wu-json/polyfuge/README.txt

Polyfuge
Documentation, Design Files, and Software for the Polyfuge DIY Microcentrifuge 

License

All Polyfuge files including the Polyfuge Educational Packet, User's Guide, BOM, design files, and software, are licensed under [GNU GPLv3](http://www.gnu.org/copyleft/gpl.html).
