wu-json/polyfuge/Polyfuge Educational Packet V1.0.pdf

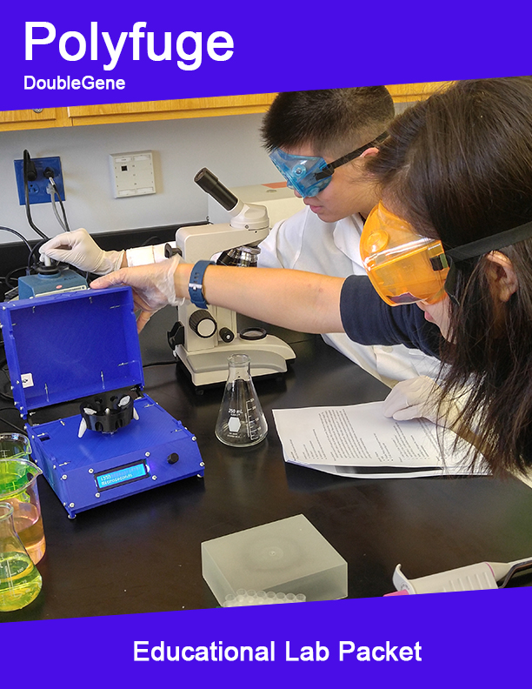
[picture p1: page 1]

## *Warning*: Centrifuges are versatile tools, but can be dangerous when handled incorrectly. Please closely read through the “Important Safety Information” section in the Polyfuge User’s Guide

before continuing.

# Disclaimer

We are not responsible for damages, injuries,

## deaths, or other ill effects arising from proper or improper use of or assembly of the Polyfuge components. To the fullest extent permissible by the applicable law, we hereby disclaim any and all responsibility, risk, liability, and damages arising out of death or personal injury resulting

from assembly of or operation of this kit.

## Polyfuge Educational Lab Packet Version 1.0

4/18/18

Biotechnology is about using living systems to make improvements to the world. From engineering fluorescent plant tissues to creating pharmaceutical drugs for treating diseases, biotechnology is an exciting interdisciplinary study that uses cells and proteins to accomplish various important tasks.

In this packet, we will be using centrifugation to extract various molecular substances using household reagents. By doing so, we will learn about the various chemical and biological principles behind common lab protocols!

In biotechnology, isolation protocols are extremely useful for chemically analyzing particular substances or even obtaining genomic data. In reverse transcription quantitative polymerase chain reaction (RT-qPCR) for example, RNA is extracted, converted to cDNA, and then analyzed with a program to measure relative gene expression.

To start off, make sure you read through the Polyfuge User’s Guide for the safety information and operation instructions. Afterwards, grab a few friends and get started!

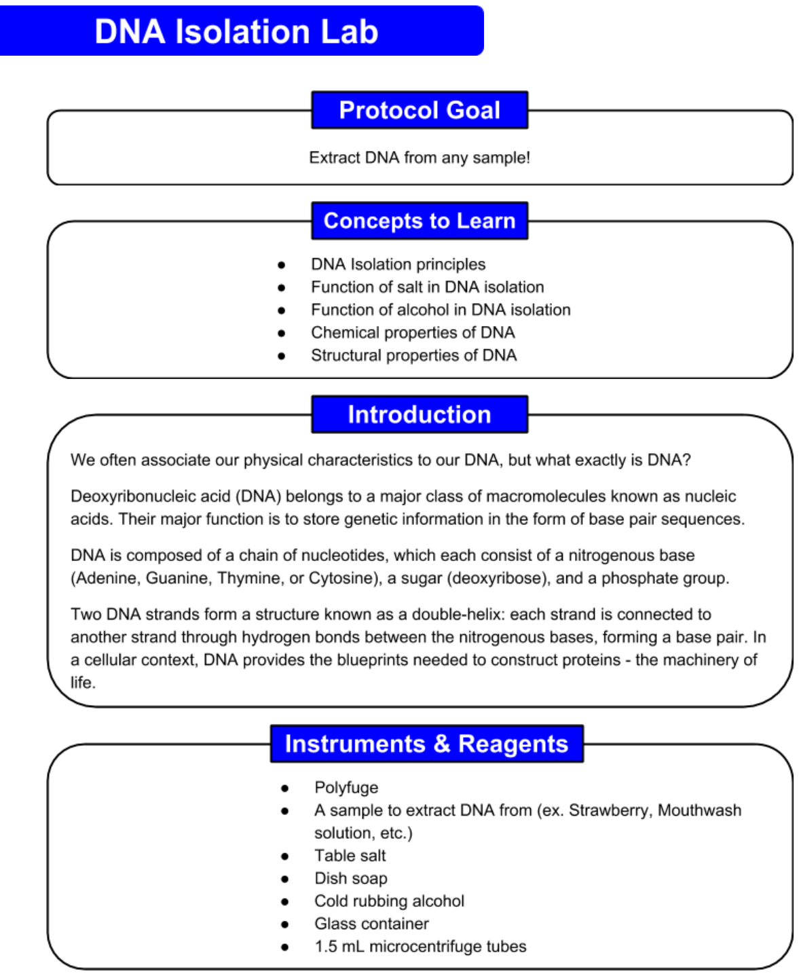
[picture p2: page 4]
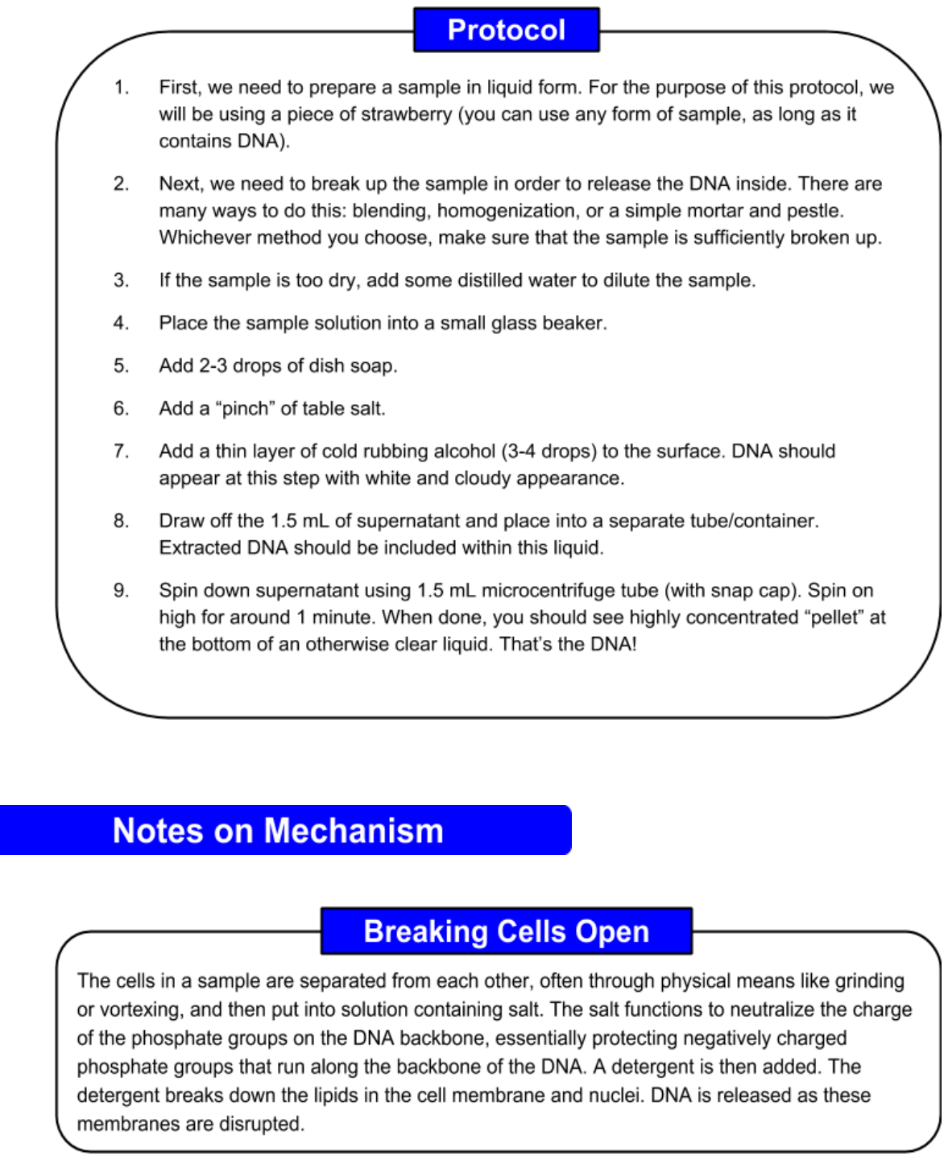
[picture p3: page 5]
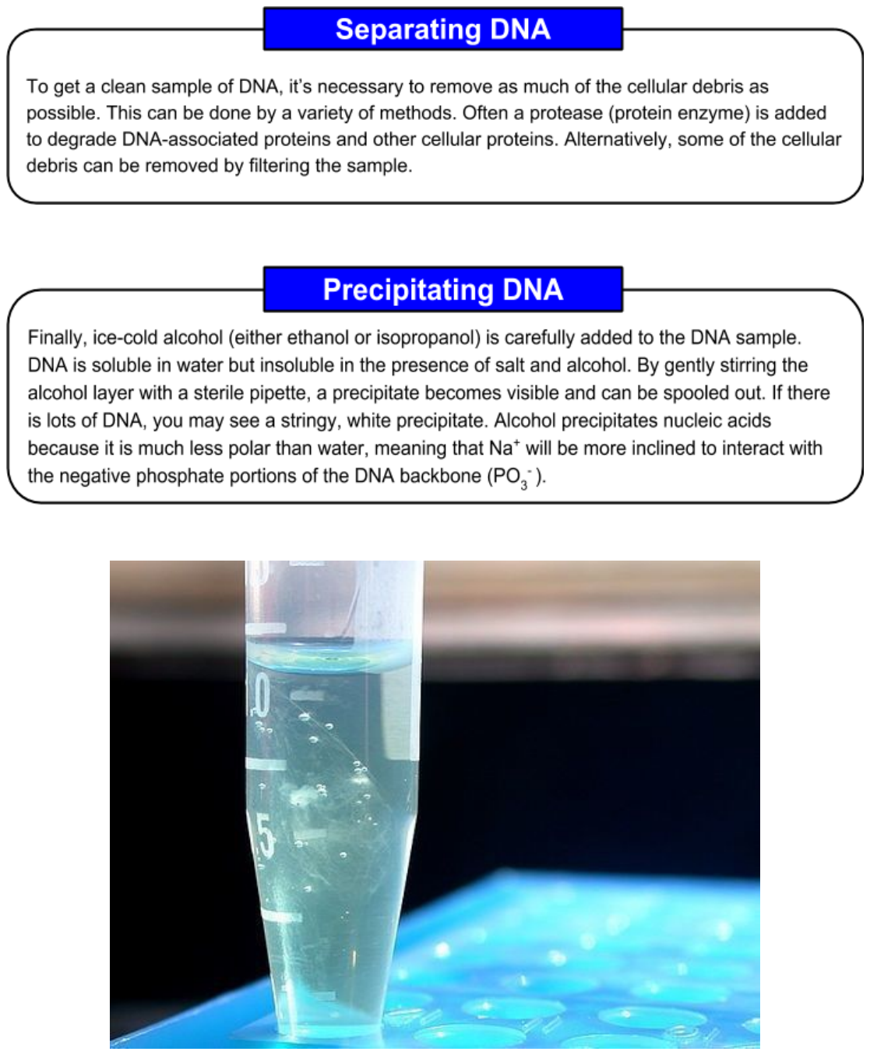
[picture p4: page 6]
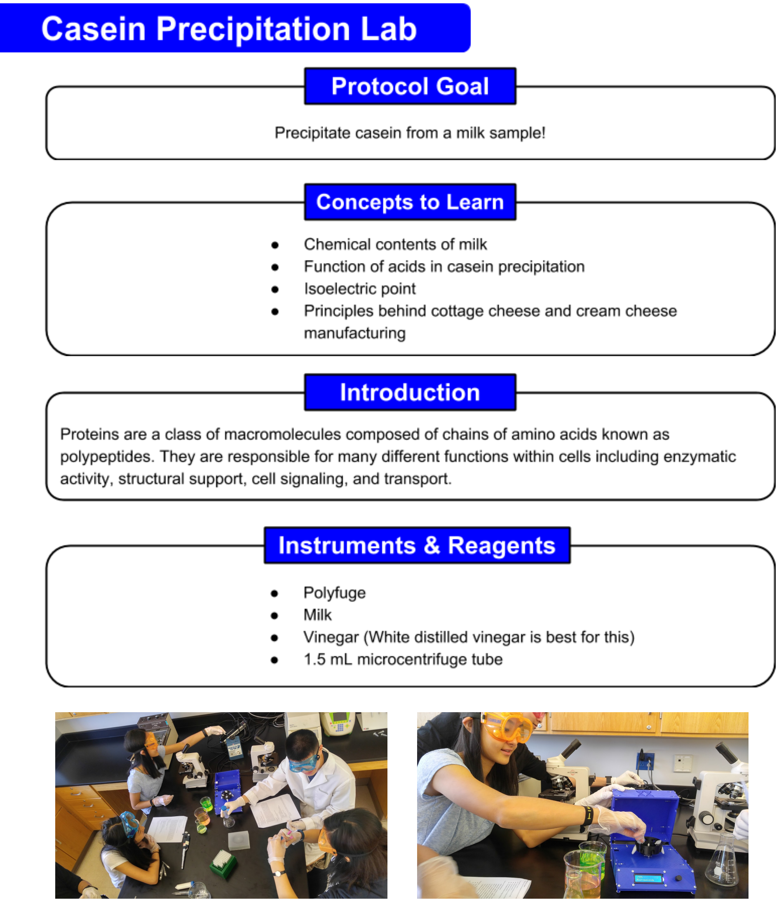
[picture p5: page 7]
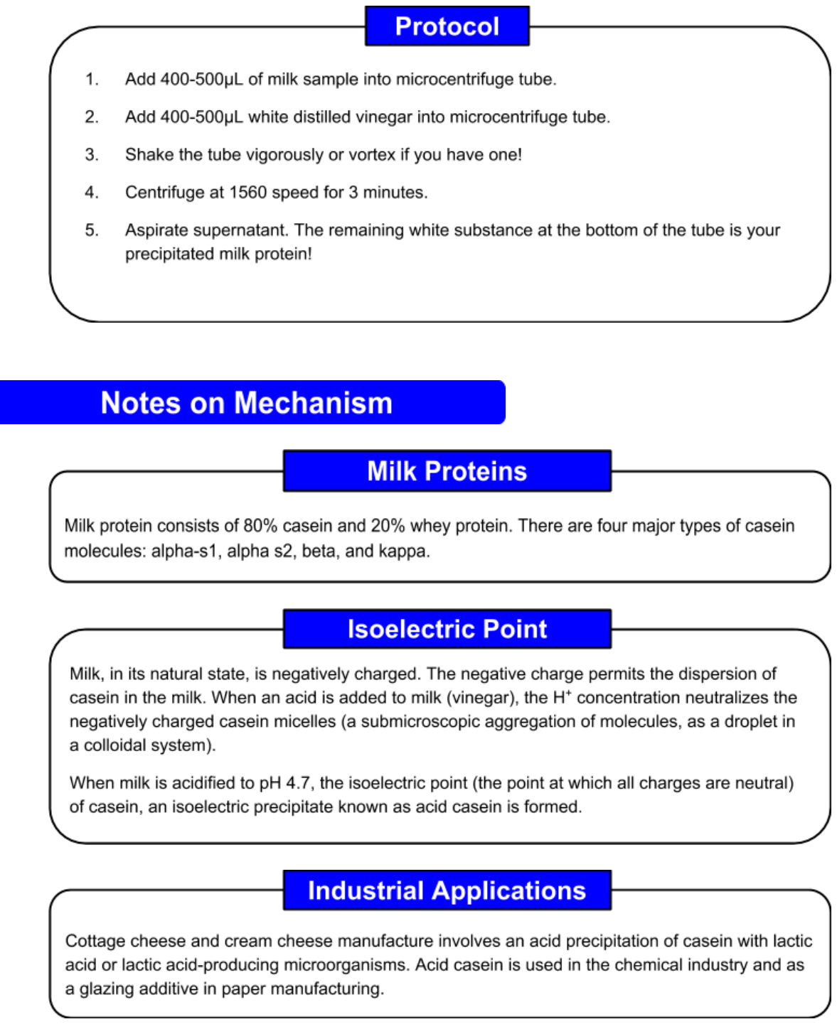
[picture p6: page 8]
