wu-json/polyfuge/Polyfuge BOM.xlsx

Quantity | Manufacturer/Vendor | Part Number | Link | Description
Electrical
1 | Arducam | C0048 | https://www.amazon.com/Arducam-Display-Controller-Character-Backlight/dp/B019D9TYMI | Main LCD for UI display
1 | uxcell | a14011500ux0042 | https://www.amazon.com/Position-Degree-Rotary-Encoder-Button/dp/B00KHTLWU6 | Rotary encoder for control
1 | Elegoo | EL-CB-004 | https://www.amazon.com/Arduino-Elegoo-board-ATmega328P-compatible/dp/B071NMBP4S | Arduino Nano microcontroller
1 | FBApayipa | B01N2U8PK0 | https://www.amazon.com/FBApayipa-Solder-Rocker-Switch-Toggle/dp/B01N2U8PK0?s=electronics | Boat Rocker Switch for ON/OFF
1 | GenBasic | 4330127279 | https://www.amazon.com/GenBasic-Female-Solderless-Breadboard-Prototyping/dp/B01L5ULRUA?s=electronics | Pack of F to F headers for circuit connections
1 | BLHeli | B01D3127NU | https://www.amazon.com/Hobbypower-BLHeli-Controller-QAV210-Quadcopter/dp/B01D3127NU | 12A ESC for centrifuge motor
1 | EMAX | B00SYH8NXC | https://www.amazon.com/Crazepony-MT2204-Brushless-Multirotor-Quadcopter/dp/B00SYH8NXC | Brushless motor for centrifuge rotor
1 | Orcity | B01MQ48T2V | https://www.amazon.com/2-54mm-Breakaway-Female-Connector-Arduino/dp/B01MQ48T2V | Pack of breakaway M and F pins for boards
1 | SUNKEE | 1361783 | https://www.amazon.com/SUNKEE-TCRT5000L-TCRT5000-Reflective-Transistor/dp/B008A3VP6M | IR sensor for lid safety interlock
1 | ALED LIGHT | B013SSU92Y | https://www.amazon.com/gp/product/B013SSU92Y/ref=oh_aui_detailpage_o00_s00?ie=UTF8&psc=1 | 2A Power adapter (US)
1 | eBoot | EXPSFD005794 | https://www.amazon.com/eBoot-LM2596-Converter-3-0-40V-1-5-35V/dp/B01GJ0SC2C | LM2596 Voltage Regulator
1 | uxcell | a15071300ux0341 | https://www.amazon.com/a15071300ux0341-Terminals-Potentiometer-Adjustable-Resistor/dp/B015AUI2TK?s=industrial | 200 Ohm trim potentiometer for LCD contrast
2 | E-Projects | B071439J4B | https://www.amazon.com/Projects-10EP51410K0-10k-Resistors-Pack/dp/B071439J4B?s=industrial | 10k Ohm resistors for circuit board
1 | E-Projects | B0725G2WM7 | https://www.amazon.com/Projects-100EP514100R-100-Resistors-Pack/dp/B0725G2WM7?s=industrial | 100 Ohm resistor for circuit board
1 | DoubleGene | N/A | See open-source files | Open-Source Polyfuge PCB
1 | ZRAMO | UK-HM023 | https://www.amazon.com/ZRAMO-5-5x2-1mm-Adapter-Connector-Security/dp/B06XXCTNX5 | Barrel Jack adapter for power supply
Mechanical
1 | DoubleGene | N/A | See open-source files | Open-Source Polyfuge centrifuge rotor
1 | DoubleGene | N/A | See open-source files | Open-Source laser cut or 3D-printed frame components
50 | McMaster-Carr | 92005A128 | https://www.mcmaster.com/#catalog/123/3033/=178lzno | 20mm M3 Steel Philips Rounded Screw
50 | McMaster-Carr | 90591A250 | https://www.mcmaster.com/#catalog/123/3210/=178m0rv | M3 Steel Hex Nut
10 | McMaster-Carr | 91166A210 | https://www.mcmaster.com/#catalog/123/3254/=178m1nk | M3 Steel Washer
50 | McMaster-Carr | 90133A005 | https://www.mcmaster.com/#standard-rubber-washers/=19akq7h | M3 Rubber Washer
4 | McMaster-Carr | 92005A120 | https://www.mcmaster.com/#machine-screws/=17ptixe | 10mm M3 Steel Philips Rounded Screw
4 | ROK Hardware | SCB03-144 | https://www.amazon.com/Rok-Hardware-Cabinet-Furniture-Diameter/dp/B00K6RZ9Q2 | Furniture bumpers to dampen vibrations on bottom of unit
Other (Raw Materials for Frame and Rotor)
1 | Hatchbox | B00J0ECR5I | https://www.amazon.com/HATCHBOX-3D-Filament-Dimensional-Accuracy/dp/B01N53KX79 | PLA Filament for printing rotor and encoder knob (use 20% infill or higher)
24" x 20" | McMaster-Carr | 8505K748 (https://www.mcmaster.com/) | https://www.mcmaster.com/#clear-impact-resistant-plastic/=1c43uxq | 3/16" Acrylic for frame pieces (purchase from local companies/stores for cheaper prices)
