wu-json/polyfuge/Polyfuge STL Files (For 3D-Printing)/Pieces/IR Blocker.stl

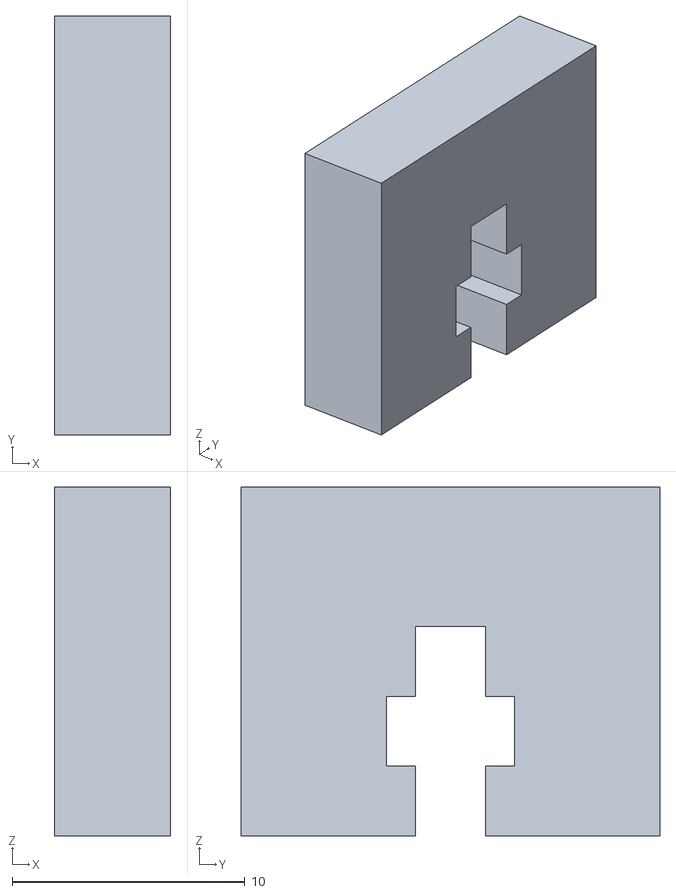
[picture p7: CAD file, 2019-02-22]
Polyfuge STL Files (For 3D-Printing)/Pieces/IR Blocker.stl
5.00 x 18.0 x 15.0
