wu-json/polyfuge/Polyfuge STL Files (For 3D-Printing)/Pieces/knob.stl

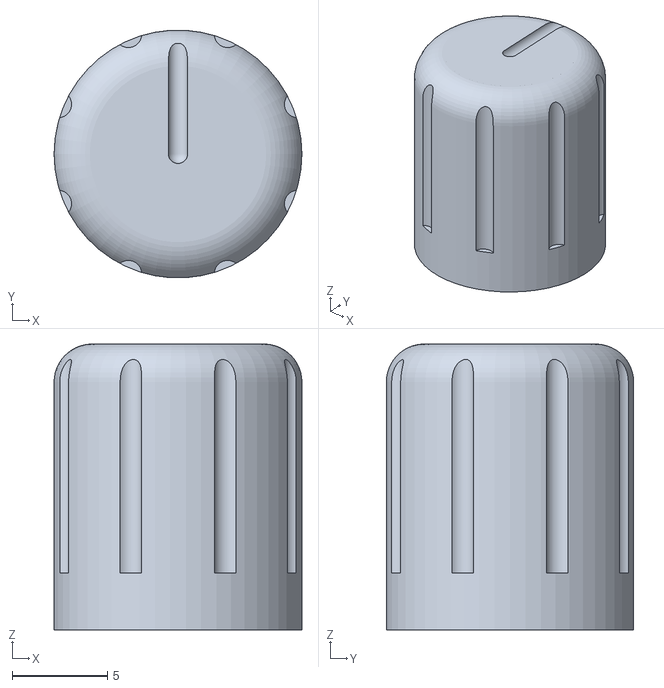
[picture p8: CAD file, 2019-02-22]
Polyfuge STL Files (For 3D-Printing)/Pieces/knob.stl
13.0 x 13.0 x 15.0
