wu-json/polyfuge/Polyfuge STL Files (For 3D-Printing)/Pieces/Side Panel (No Mounts).stl

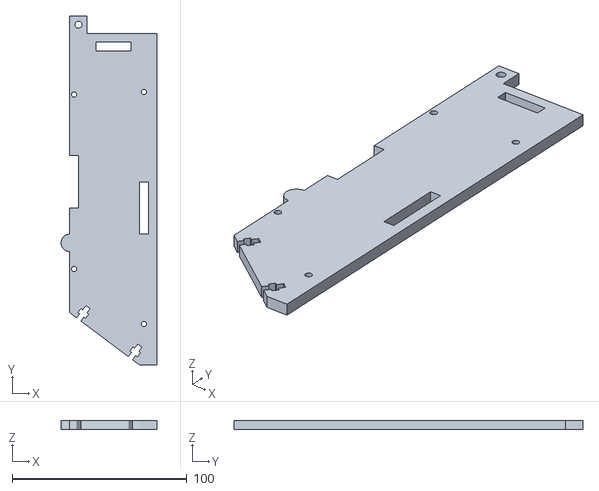
[picture p9: CAD file, 2019-02-22]
Polyfuge STL Files (For 3D-Printing)/Pieces/Side Panel (No Mounts).stl
55.0 x 200.0 x 5.00
