wu-json/polyfuge/Polyfuge STL Files (For 3D-Printing)/Pieces/Rotor.stl

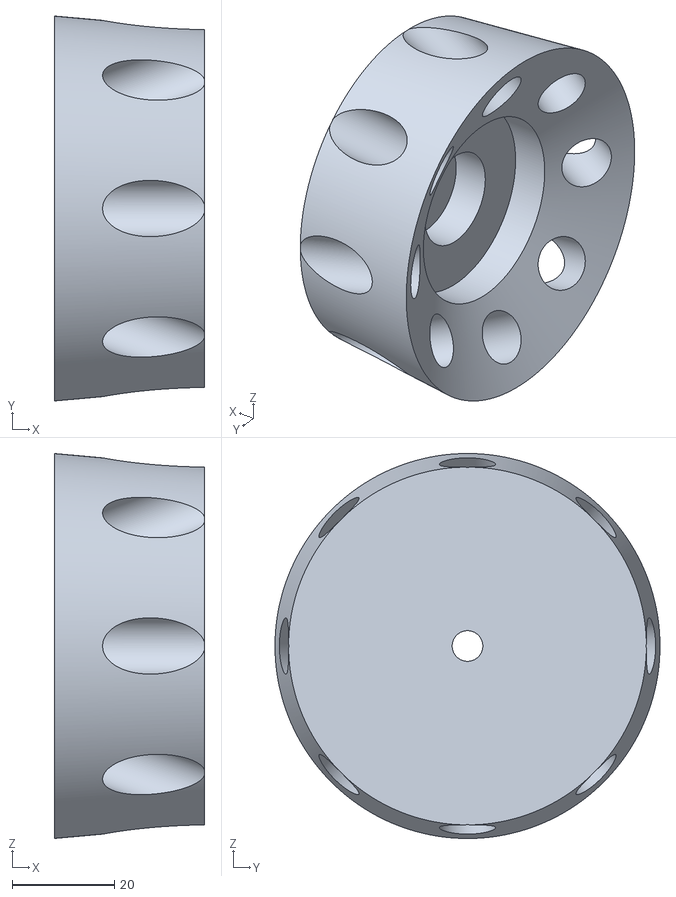
[picture p10: CAD file, 2019-02-22]
Polyfuge STL Files (For 3D-Printing)/Pieces/Rotor.stl
29.4 x 75.3 x 75.3
