wu-json/polyfuge/Polyfuge STL Files (For 3D-Printing)/Pieces/Top Top Panel.stl

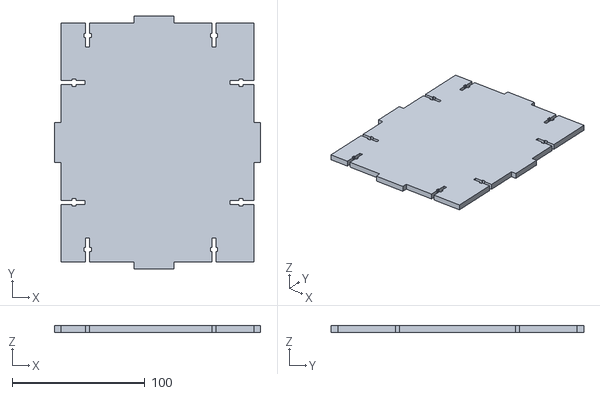
[picture p11: CAD file, 2019-02-22]
Polyfuge STL Files (For 3D-Printing)/Pieces/Top Top Panel.stl
155.0 x 190.0 x 5.00
