wu-json/polyfuge/Polyfuge STL Files (For 3D-Printing)/Pieces/Front Panel.stl

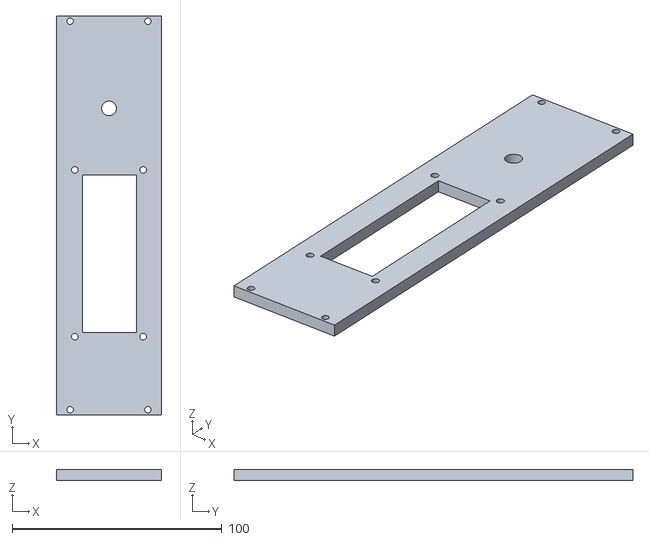
[picture p12: CAD file, 2019-02-22]
Polyfuge STL Files (For 3D-Printing)/Pieces/Front Panel.stl
50.0 x 190.0 x 5.00
