wu-json/polyfuge/Polyfuge STL Files (For 3D-Printing)/Pieces/Top Side Panel (NO IR BLOCKER).stl

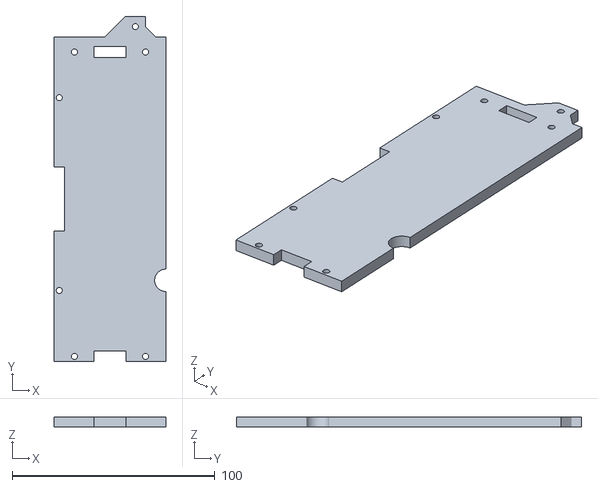
[picture p13: CAD file, 2019-02-22]
Polyfuge STL Files (For 3D-Printing)/Pieces/Top Side Panel (NO IR BLOCKER).stl
55.0 x 170.0 x 5.00
