wu-json/polyfuge/Polyfuge STL Files (For 3D-Printing)/Pieces/Side Panel Hinge.stl

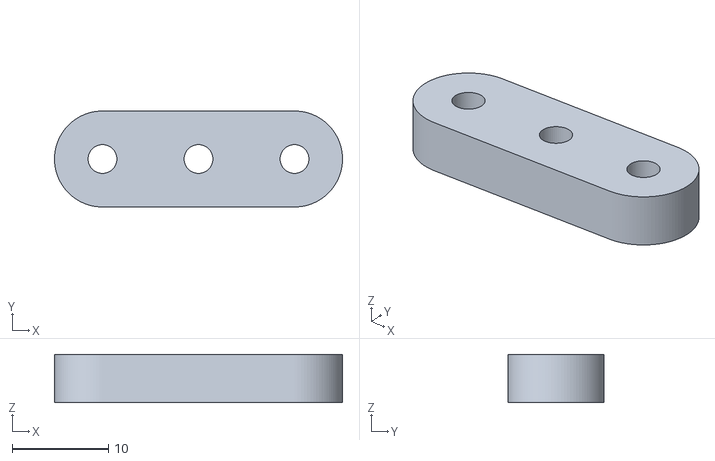
[picture p14: CAD file, 2019-02-22]
Polyfuge STL Files (For 3D-Printing)/Pieces/Side Panel Hinge.stl
30.0 x 10.0 x 5.00
