wu-json/polyfuge/Polyfuge STL Files (For 3D-Printing)/Pieces/Back Panel.stl

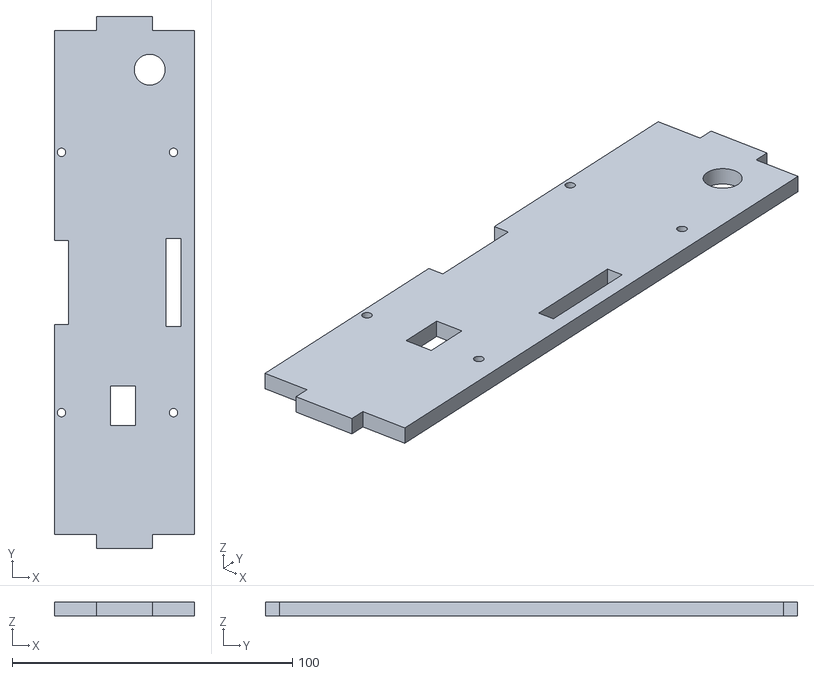
[picture p16: CAD file, 2019-02-22]
Polyfuge STL Files (For 3D-Printing)/Pieces/Back Panel.stl
50.0 x 190.0 x 5.00
