wu-json/polyfuge/Polyfuge STL Files (For 3D-Printing)/Pieces/Top Front Panel (With Design DoubleGene).stl

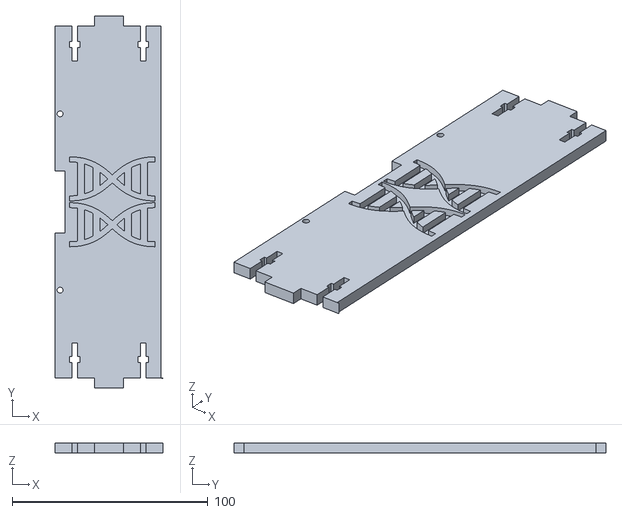
[picture p18: CAD file, 2019-02-22]
Polyfuge STL Files (For 3D-Printing)/Pieces/Top Front Panel (With Design DoubleGene).stl
55.0 x 190.0 x 5.00
