wu-json/polyfuge/Polyfuge STL Files (For 3D-Printing)/Pieces/Rotor V2.stl

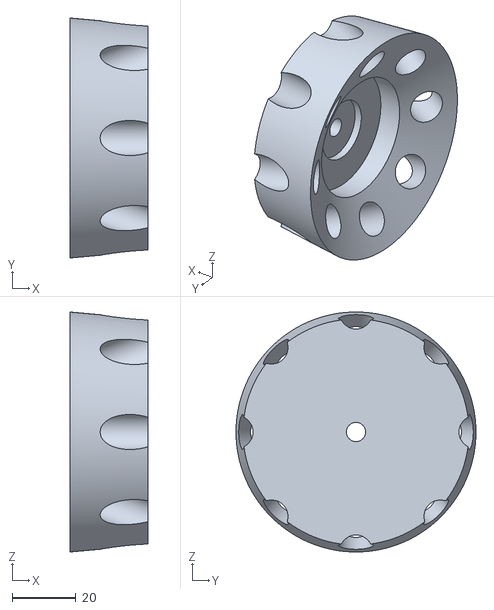
[picture p19: CAD file, 2019-02-22]
Polyfuge STL Files (For 3D-Printing)/Pieces/Rotor V2.stl
24.4 x 75.3 x 75.3
