wu-json/polyfuge/Polyfuge STL Files (For 3D-Printing)/Pieces/Top Back Panel.stl

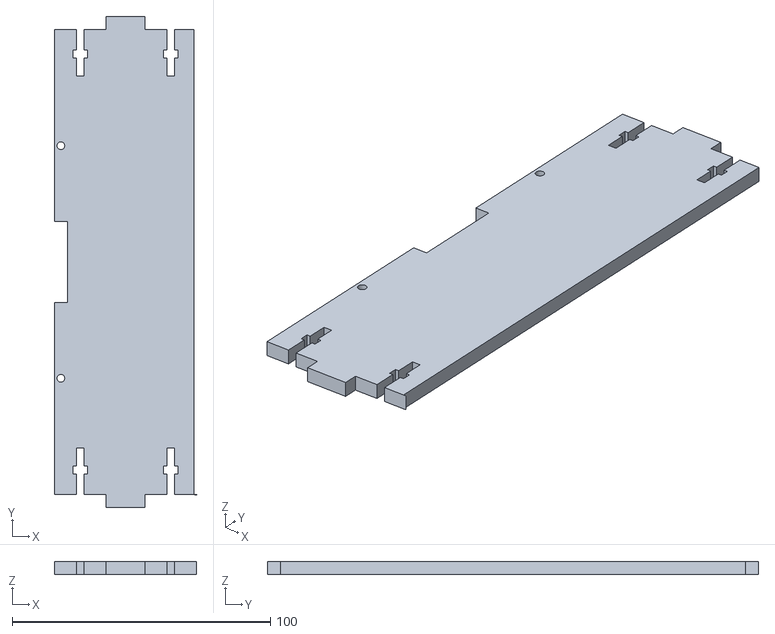
[picture p20: CAD file, 2019-02-22]
Polyfuge STL Files (For 3D-Printing)/Pieces/Top Back Panel.stl
55.0 x 190.0 x 5.00
