wu-json/polyfuge/(list of files, cad)

Other CAD files:
Polyfuge STL Files (For 3D-Printing)/Pieces/Side Panel (USB).stl
Polyfuge STL Files (For 3D-Printing)/Pieces/Side Panel (Optical).stl
Polyfuge STL Files (For 3D-Printing)/Pieces/Top Side Panel (IR Blocker).stl
