wu-json/polyfuge/(notices)

Notices in the files:
Polyfuge_Software_V1.0.ino:
modify it under the terms of the GNU General Public License as published
